ohjaeyoung0519/edge-iot-vision-control-system/images/hardware/breadboard_jumper_wires.jpeg

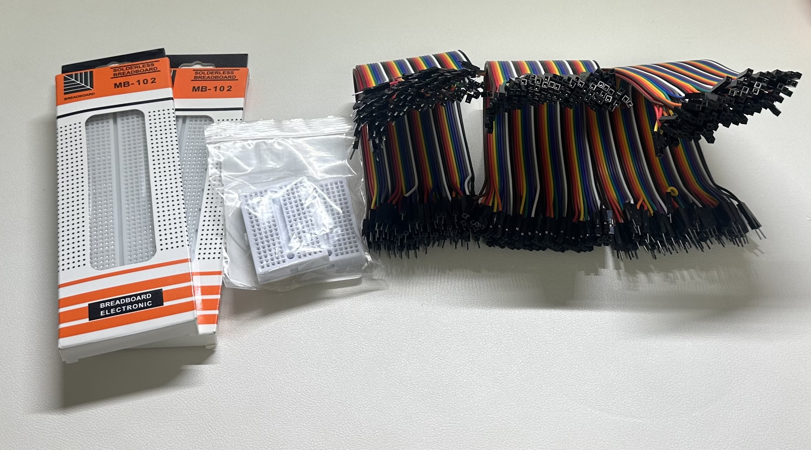
images/hardware/breadboard_jumper_wires.jpeg
