ohjaeyoung0519/edge-iot-vision-control-system/images/hardware/digital_multimeter.jpeg

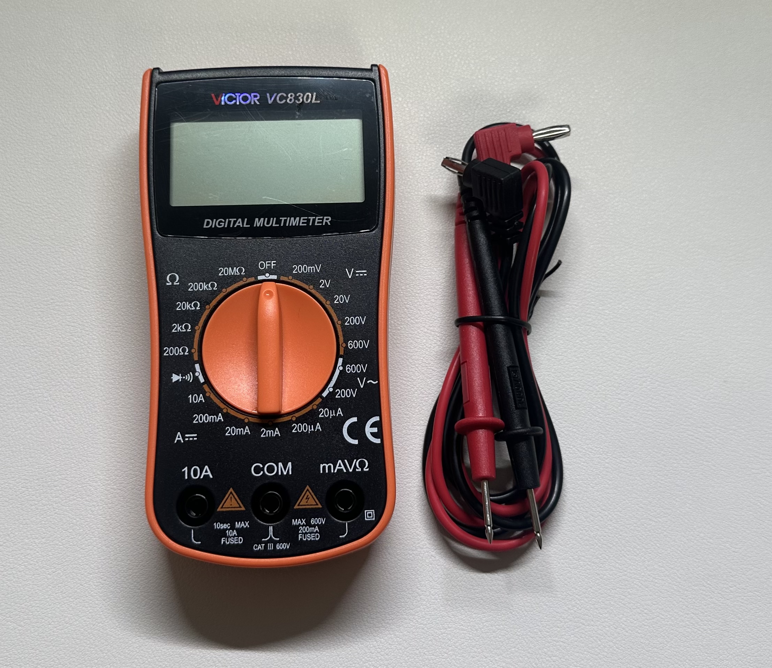
images/hardware/digital_multimeter.jpeg
