ohjaeyoung0519/edge-iot-vision-control-system/images/hardware/hardware_overview.jpeg

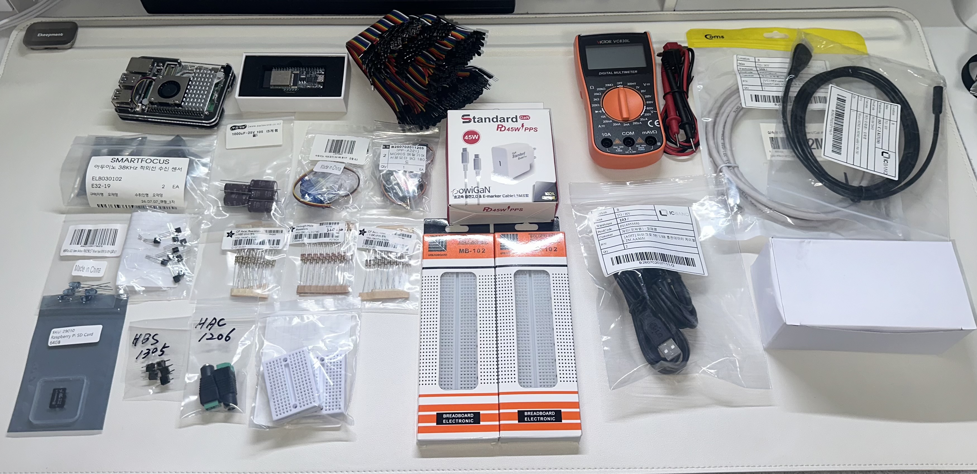
images/hardware/hardware_overview.jpeg
