ohjaeyoung0519/edge-iot-vision-control-system/images/hardware/raspberry_pi5_case_cooler.jpeg

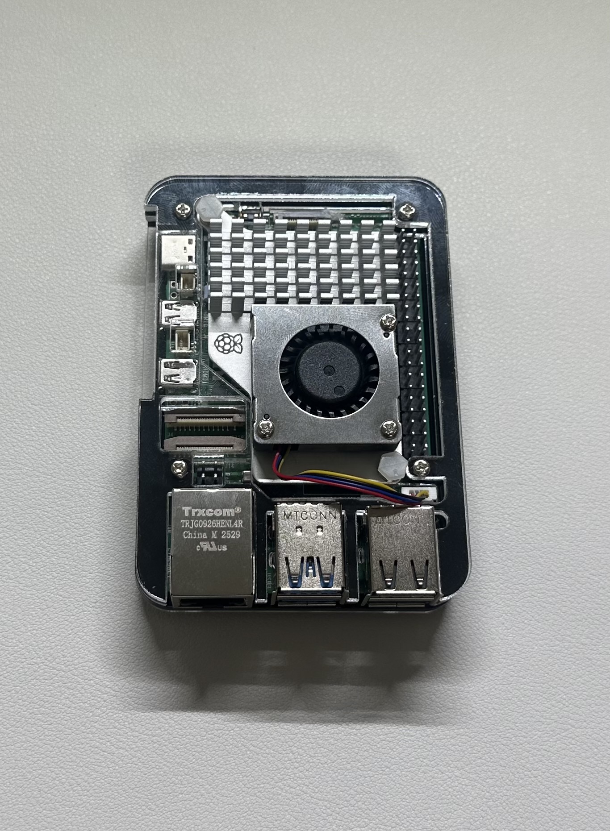
images/hardware/raspberry_pi5_case_cooler.jpeg
