ohjaeyoung0519/edge-iot-vision-control-system/images/hardware/raspberry_pi5_side_ports.jpeg

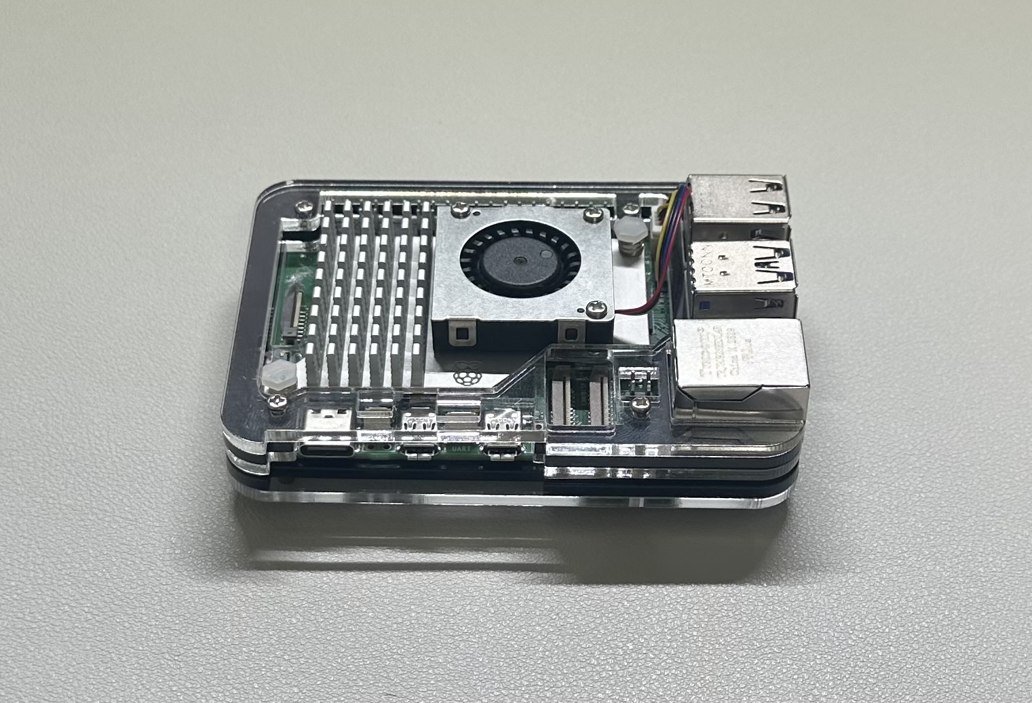
images/hardware/raspberry_pi5_side_ports.jpeg
