ohjaeyoung0519/edge-iot-vision-control-system/images/hardware/servo_motors.jpeg

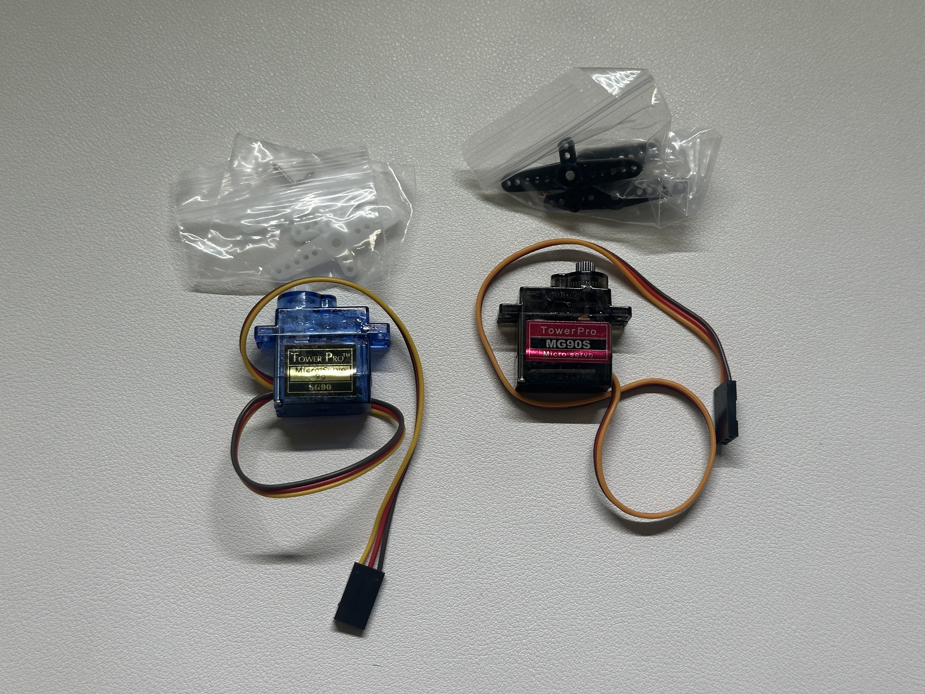
images/hardware/servo_motors.jpeg
