ohjaeyoung0519/edge-iot-vision-control-system/images/hardware/ir_components.jpeg

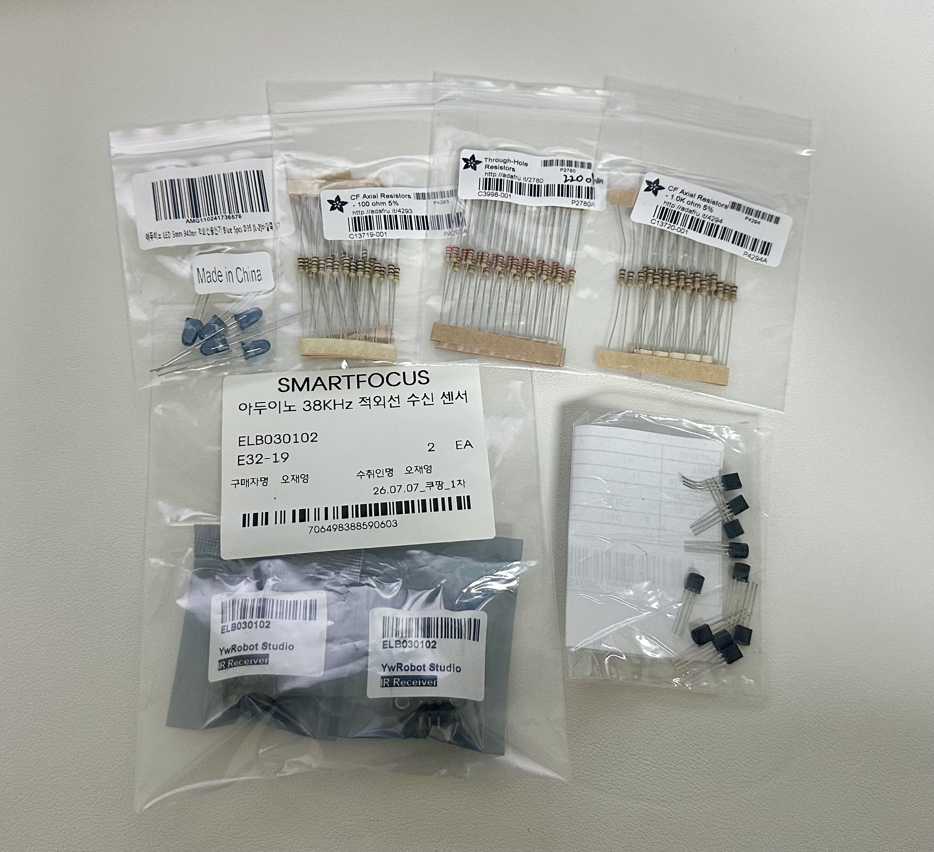
images/hardware/ir_components.jpeg
