ohjaeyoung0519/edge-iot-vision-control-system/images/hardware/power_components.jpeg

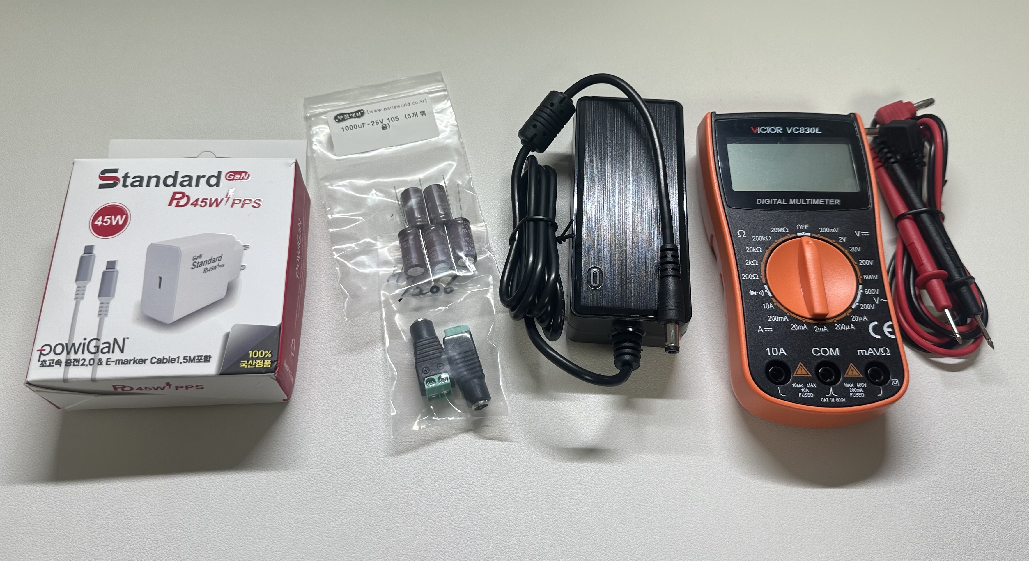
images/hardware/power_components.jpeg
