ohjaeyoung0519/edge-iot-vision-control-system/images/hardware/power_wiring_tools_and_connectors.jpeg

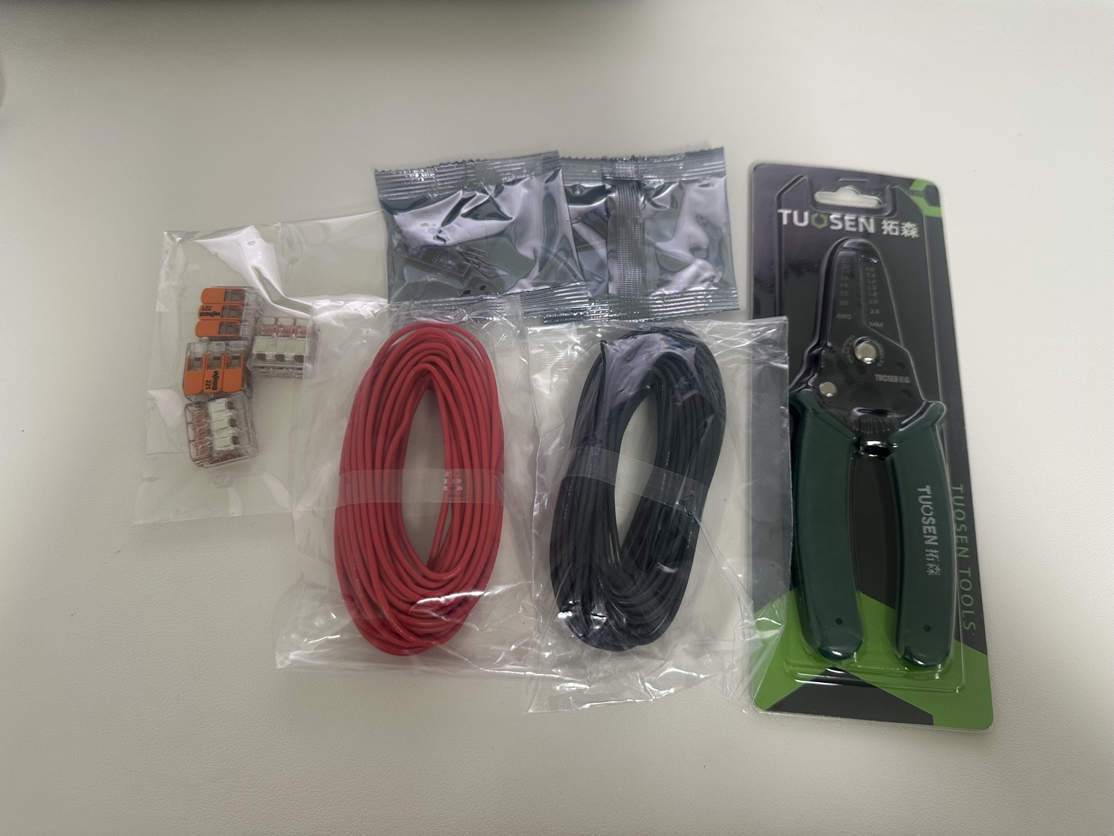
images/hardware/power_wiring_tools_and_connectors.jpeg
