ohjaeyoung0519/edge-iot-vision-control-system/images/results/raspberry_pi_and_servo_power_wiring.jpeg

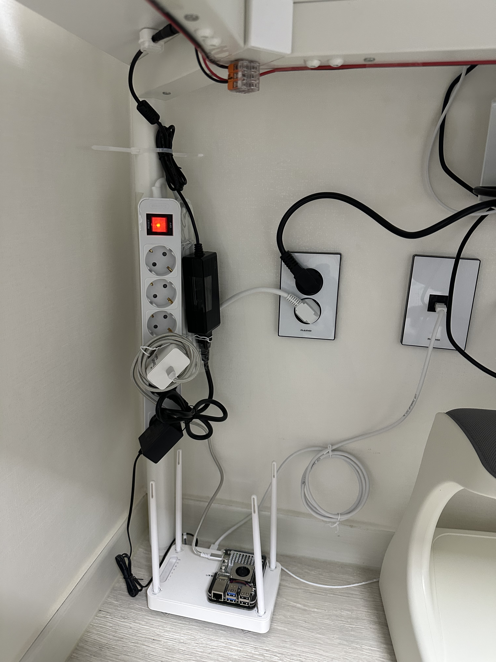
images/results/raspberry_pi_and_servo_power_wiring.jpeg
