ohjaeyoung0519/edge-iot-vision-control-system/data/processed/servo_ldr_measurement_10min_clean.csv

elapsed_s | trial | action | angle | duration_ms | heap_before | heap_after | heap_diff | ldr_raw
1.0 | 1 | press_left | 60 | 999.6 | 330252 | 330252 | 0 | 711
4.0 | 2 | press_right | 120 | 1000.0 | 329648 | 329648 | 0 | 710
8.0 | 3 | press_left | 60 | 999.99 | 329648 | 329648 | 0 | 714
11.0 | 4 | press_right | 120 | 1000.0 | 329648 | 329648 | 0 | 716
15.0 | 5 | press_left | 60 | 999.99 | 329648 | 329648 | 0 | 713
18.0 | 6 | press_right | 120 | 1000.0 | 329648 | 329648 | 0 | 710
22.0 | 7 | press_left | 60 | 999.99 | 329648 | 329648 | 0 | 709
25.0 | 8 | press_right | 120 | 1000.0 | 329648 | 329648 | 0 | 766
29.0 | 9 | press_left | 60 | 999.99 | 329648 | 329648 | 0 | 709
32.0 | 10 | press_right | 120 | 1000.0 | 329648 | 329648 | 0 | 711
36.0 | 11 | press_left | 60 | 999.99 | 329648 | 329648 | 0 | 712
39.0 | 12 | press_right | 120 | 1000.0 | 329648 | 329648 | 0 | 714
43.0 | 13 | press_left | 60 | 999.99 | 329648 | 329648 | 0 | 720
46.0 | 14 | press_right | 120 | 1000.0 | 329648 | 329648 | 0 | 721
50.0 | 15 | press_left | 60 | 999.99 | 329648 | 329648 | 0 | 723
53.0 | 16 | press_right | 120 | 1000.0 | 329648 | 329648 | 0 | 722
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
