ohjaeyoung0519/edge-iot-vision-control-system/images/hardware/temperature_measurement_tool.jpeg

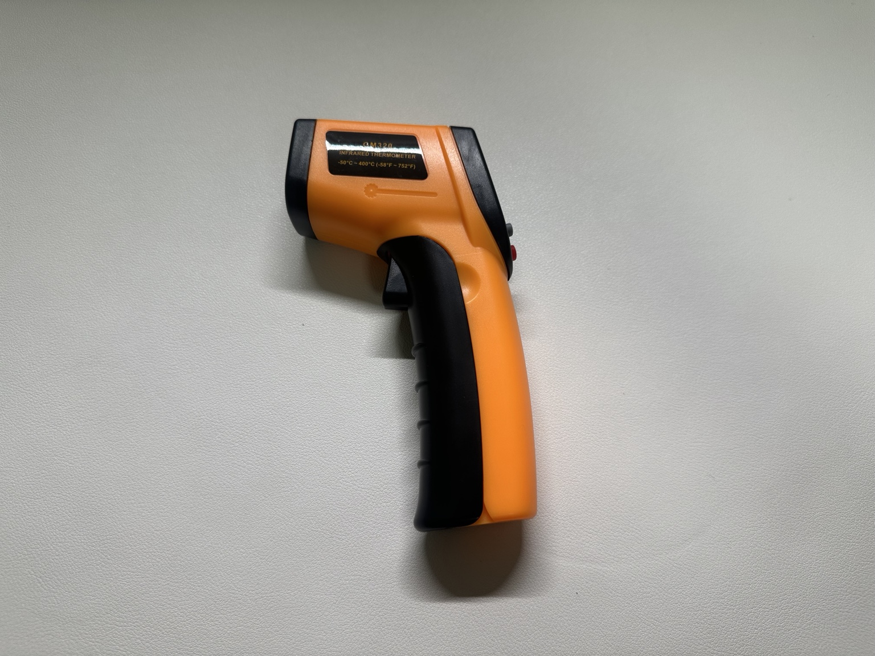
images/hardware/temperature_measurement_tool.jpeg
