ohjaeyoung0519/edge-iot-vision-control-system/images/results/esp32_board_info_serial_monitor.png

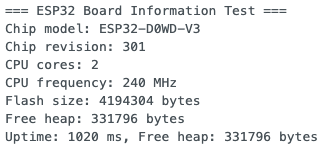
images/results/esp32_board_info_serial_monitor.png
