ohjaeyoung0519/edge-iot-vision-control-system/images/results/esp32_http_ping_browser.png

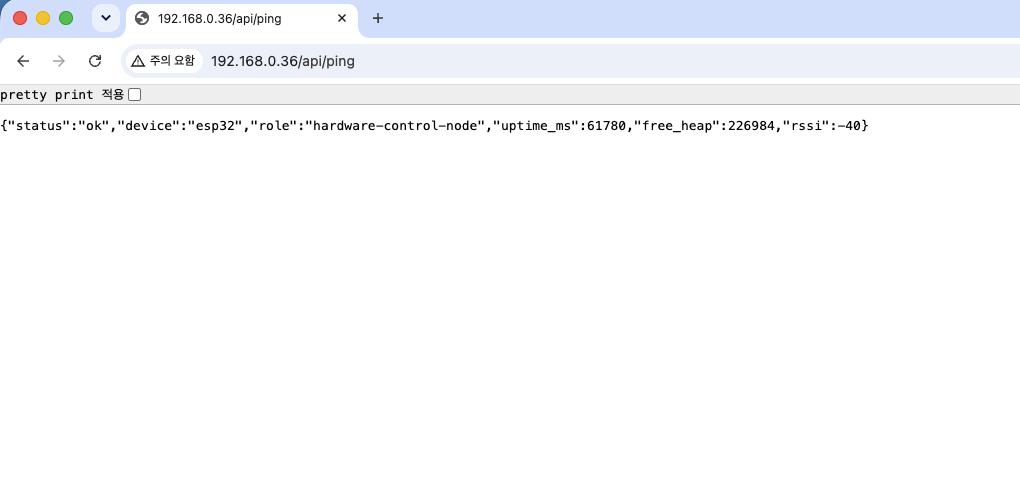
images/results/esp32_http_ping_browser.png
