ohjaeyoung0519/edge-iot-vision-control-system/images/results/esp32_http_server_serial_monitor.png

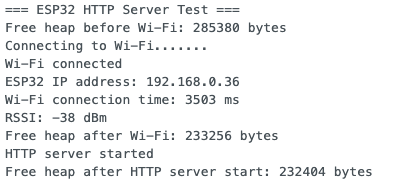
images/results/esp32_http_server_serial_monitor.png
