ohjaeyoung0519/edge-iot-vision-control-system/images/results/esp32_wifi_test_serial_monitor.png

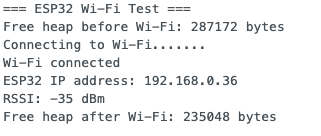
images/results/esp32_wifi_test_serial_monitor.png
