ohjaeyoung0519/edge-iot-vision-control-system/images/results/integrated_dashboard_light_node.png

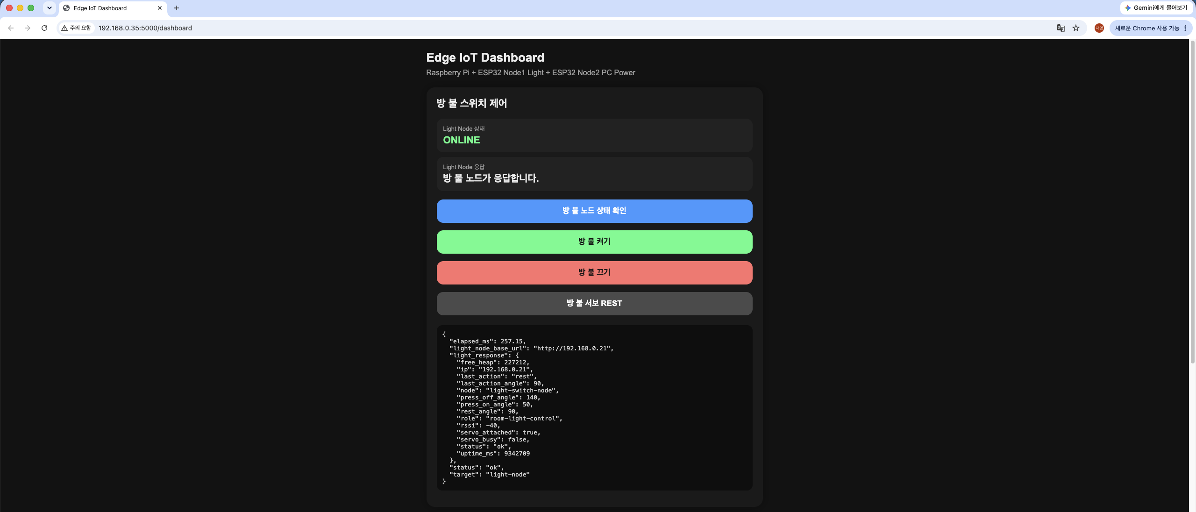
images/results/integrated_dashboard_light_node.png
