ohjaeyoung0519/edge-iot-vision-control-system/images/results/integrated_dashboard_pc_power.png

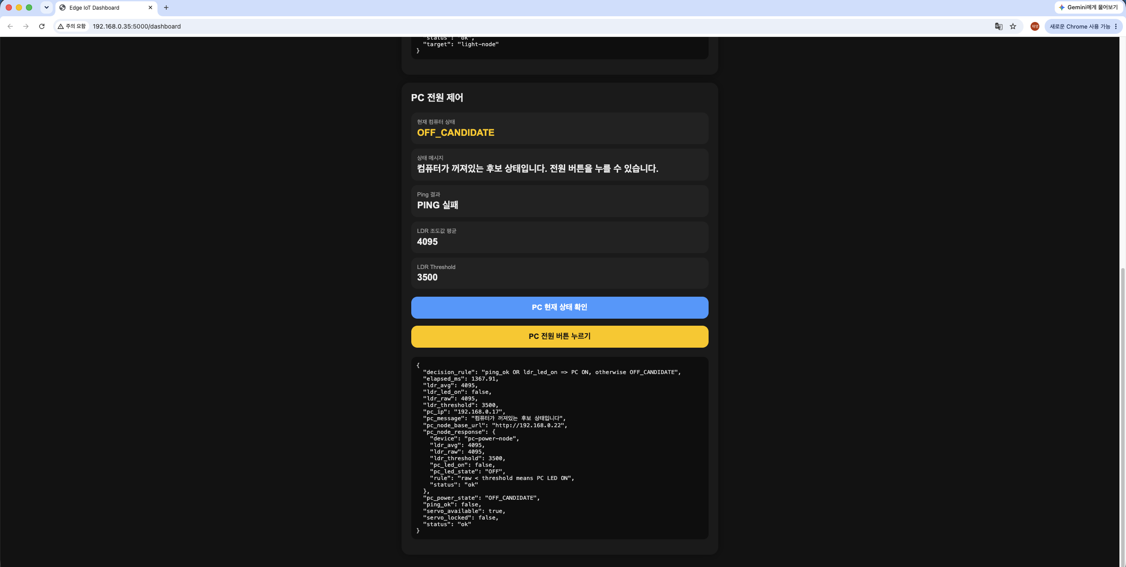
images/results/integrated_dashboard_pc_power.png
