ohjaeyoung0519/edge-iot-vision-control-system/images/results/light_switch_node_servo_mount.jpeg

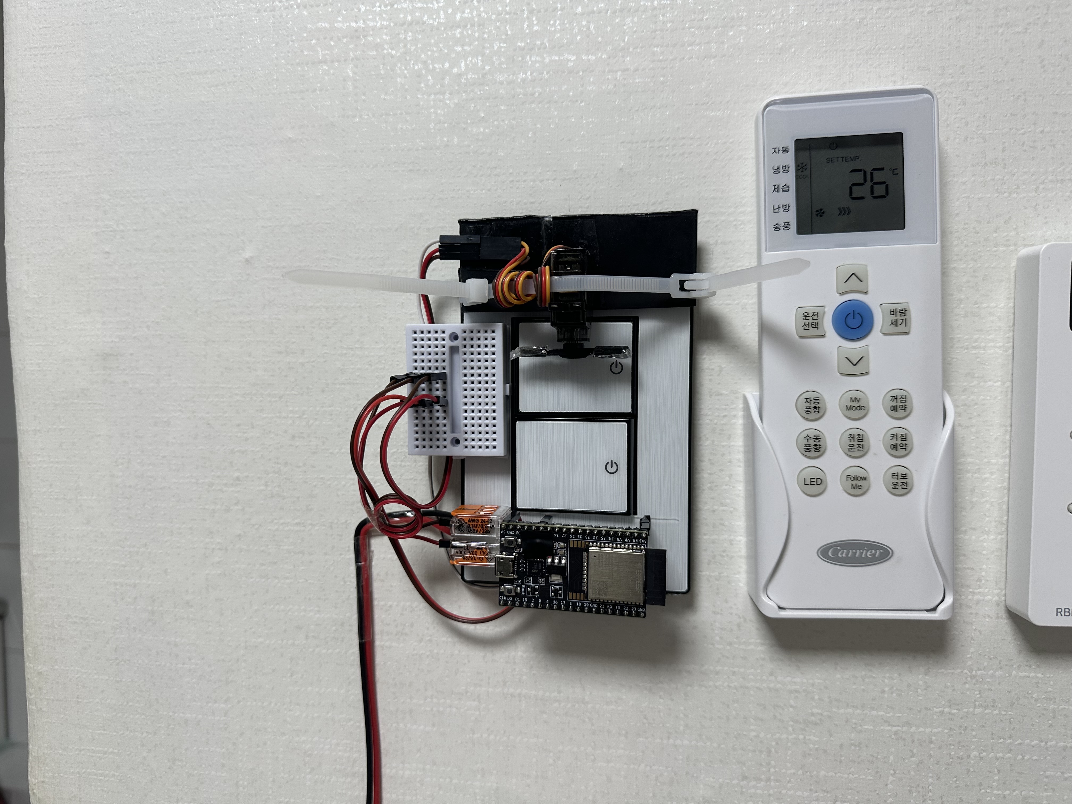
images/results/light_switch_node_servo_mount.jpeg
