ohjaeyoung0519/edge-iot-vision-control-system/images/results/mg90s_temperature_5min.jpeg

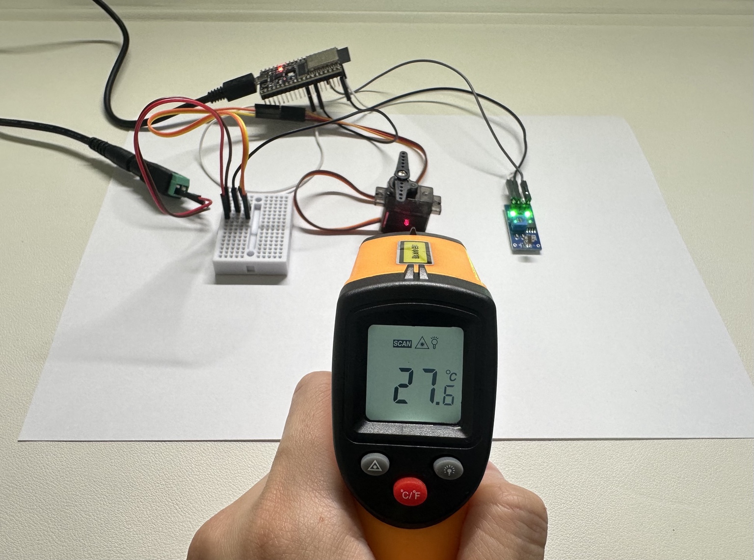
images/results/mg90s_temperature_5min.jpeg
