ohjaeyoung0519/edge-iot-vision-control-system/images/results/mg90s_temperature_10min.jpeg

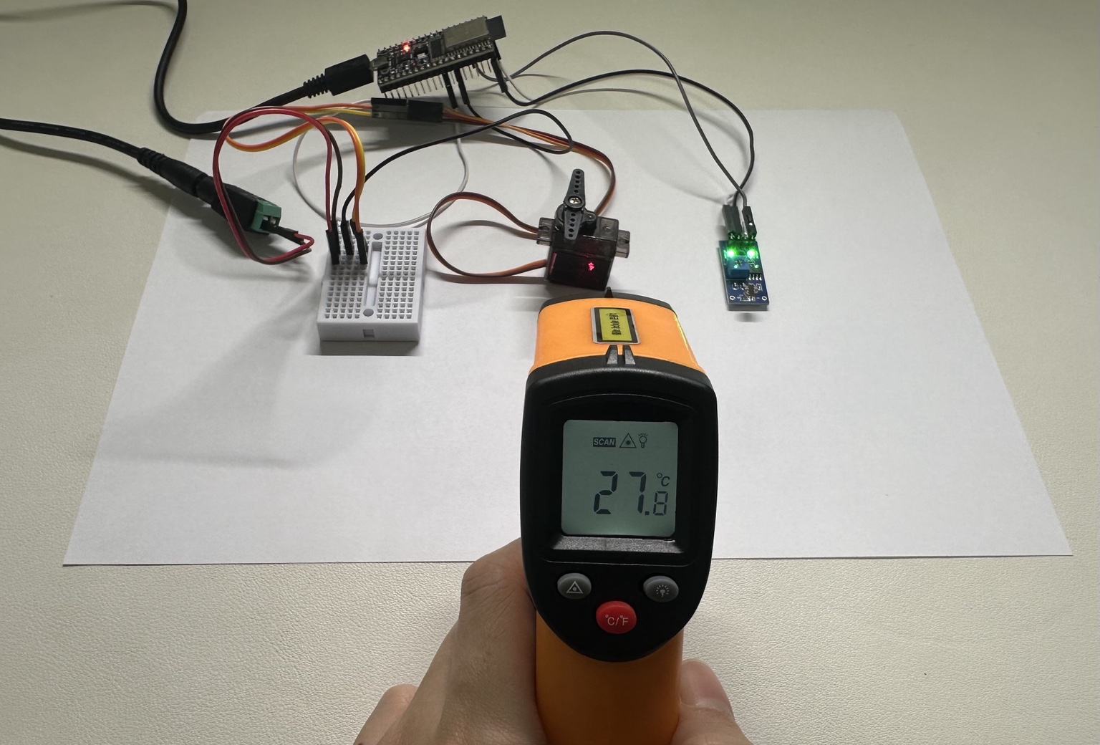
images/results/mg90s_temperature_10min.jpeg
