ohjaeyoung0519/edge-iot-vision-control-system/images/results/mg90s_temperature_before.jpeg

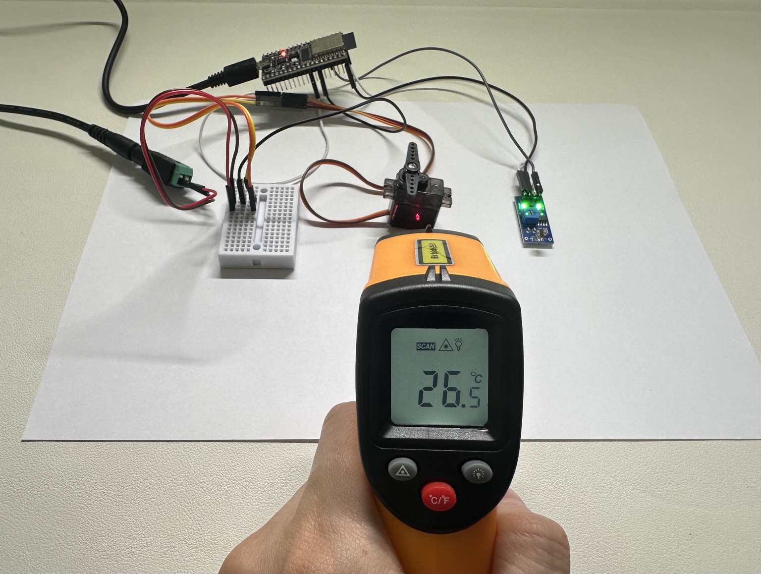
images/results/mg90s_temperature_before.jpeg
