ohjaeyoung0519/edge-iot-vision-control-system/images/results/pc_power_node_servo_ldr_mount.jpeg

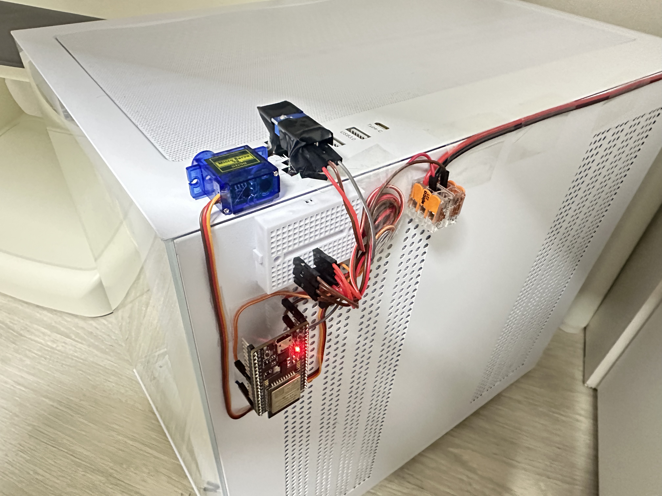
images/results/pc_power_node_servo_ldr_mount.jpeg
