ohjaeyoung0519/edge-iot-vision-control-system/images/results/pc_power_node_web_ui.png

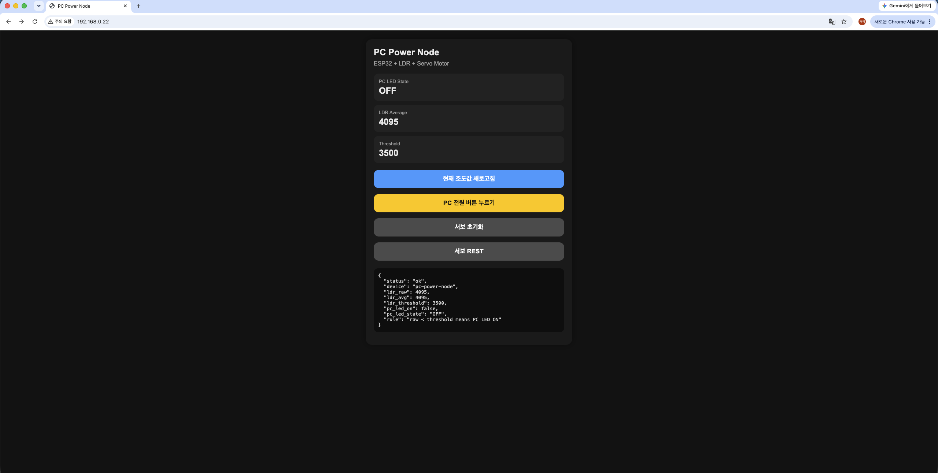
images/results/pc_power_node_web_ui.png
