ohjaeyoung0519/edge-iot-vision-control-system/images/results/pi_flask_server_test.png

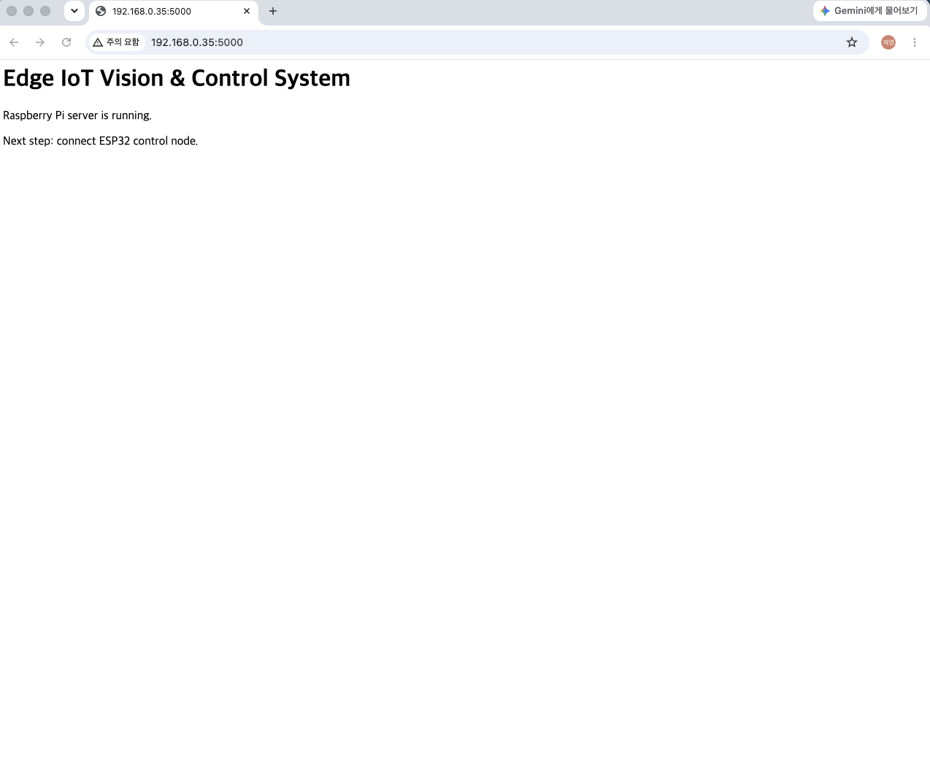
images/results/pi_flask_server_test.png
