ohjaeyoung0519/edge-iot-vision-control-system/images/results/raspberry_pi_flask_to_esp32_ping.png

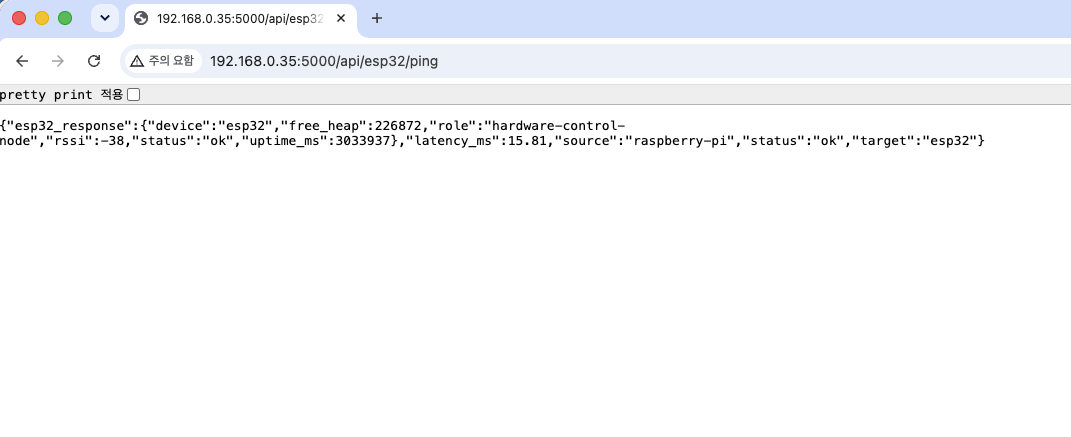
images/results/raspberry_pi_flask_to_esp32_ping.png
