ohjaeyoung0519/edge-iot-vision-control-system/images/results/raspberry_pi_to_esp32_curl_success.png

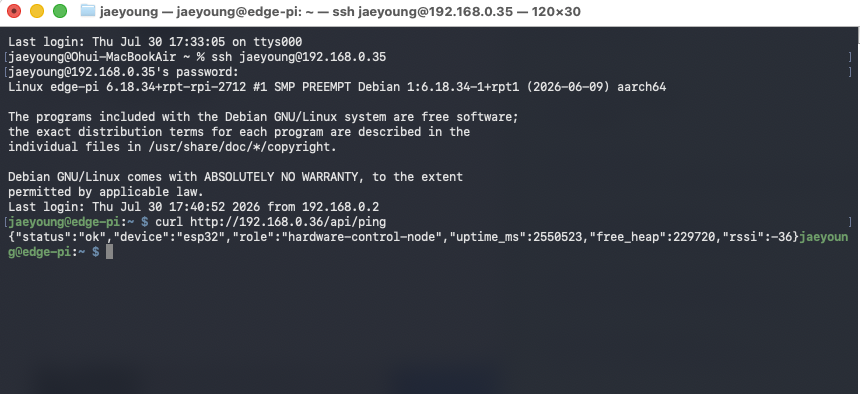
images/results/raspberry_pi_to_esp32_curl_success.png
