ohjaeyoung0519/edge-iot-vision-control-system/images/results/rpi_to_esp32_latency_100_requests.png

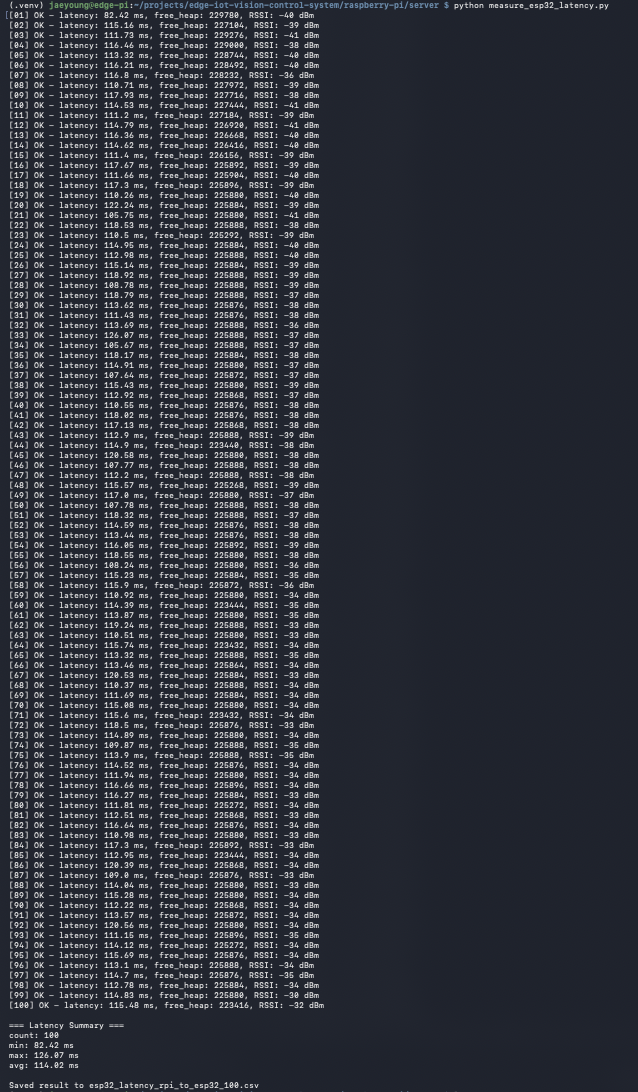
images/results/rpi_to_esp32_latency_100_requests.png
