ohjaeyoung0519/edge-iot-vision-control-system/(commit log)

2026-07-24 Update README.md
    docs: check ESP32 received
2026-07-25 raspberry-pi: add initial Flask test server
2026-07-25 docs: record Raspberry Pi setup and server test
2026-07-30 feat: add Raspberry Pi to ESP32 communication test
    - Add Flask endpoint for Raspberry Pi to ESP32 ping forwarding
    - Add ESP32 latency measurement script
    - Add 100-request latency measurement result CSV
    - Add result screenshots for ESP32 Wi-Fi, HTTP server, and Raspberry Pi communication tests
    [esp32_latency_rpi_to_esp32_100.csv]
2026-08-04 test: add servo and LDR sensor preliminary tests
2026-08-05 test: add MG90S servo stability measurement results and update docs
    [esp32_latency_rpi_to_esp32_100.csv, esp32_latency_rpi_to_esp32_summary.csv, mg90s_temperature_summary.csv, servo_ldr_measurement_10min_clean.csv, servo_ldr_measurement_summary.csv]
2026-08-05 test: add servo and LDR measurement sketch
2026-08-05 test: light switch node test
2026-08-06 feat: add PC power node and prototype setup images and add raspberry-pi server
2026-08-06 docs: document integrated dashboard prototype
    - Add experiment log for Light Switch Node and PC Power Node integration
    - Update README with current system architecture, dashboard features, and test results
